YangPiCui/ErgonomicComputerKeyboard/Versions/ECK_0.2.0/README.md

# [Case](Case) 
. use low latency and cheap components (Teensy 2.0, atmega, rp2040)  
. desktop app to manage key maps - qwerty default and includes mine  

# Part List  

# Keymap 
[Layer0](http://www.keyboard-layout-editor.com/#/gists/2fc38dca845ec5f253bac7c052df82da)  
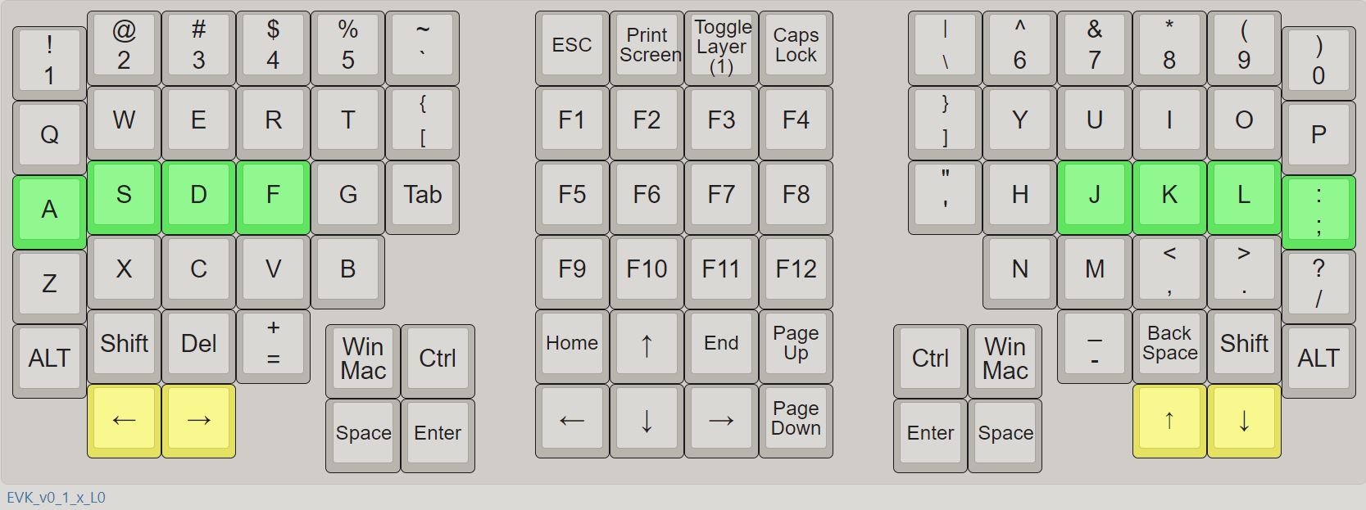
[picture p3: Versions/ECK_0.2.0/EVK_v0_1_x_L0.jpg]
  
[Layer1](http://www.keyboard-layout-editor.com/#/gists/1d35c2bdc8fc2de6860daa4e2ee97f45)  
I manually designed a keymap based on English [letter](https://norvig.com/mayzner.html) and [character](http://xahlee.info/comp/computer_language_char_distribution.html) frequencies. [It fares well against other traidtional layouts according to the Keyboard Layout Analyzer.](http://patorjk.com/keyboard-layout-analyzer/#/load/hqrGn4NG)  
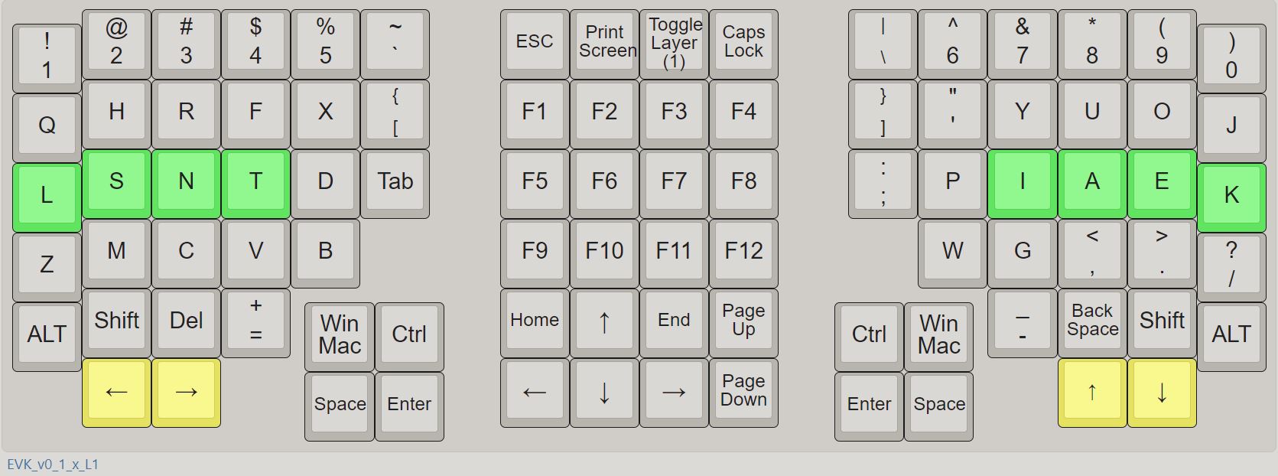
[picture p4: Versions/ECK_0.2.0/EVK_v0_1_x_L1.jpg]
  

# [Electronics, Firmware and Software](ElectronicsFirmwareSoftware)

# 3D Print 
"./3DPrintFiles/"  
"./CuraSlicerSettings/" 
The parts are of high precision. The fits are transitional clearance. [Calibrate](https://github.com/YangPiCui/3DPrinterCalibrationAndTuning/) your 3D printer accurately and follow the instructions closely. 

### Left Right and Front  
* Nozzle Diameter 0.3mm
* Layer Height 0.24mm
* Line Width 0.54mm
* Support Line Width 0.24mm for easy support removal   
* Tree Support Top Distance is 0.48mm, or twice the layer height. IMPORTANT. Do NOT set this value greater than what I have specified, otherwise the keyswitch might not fit. 
Print the Left Right and Front as if they would normally stand on the build plate. Set brim distance to 0mm for Front but not for Left or Right.  
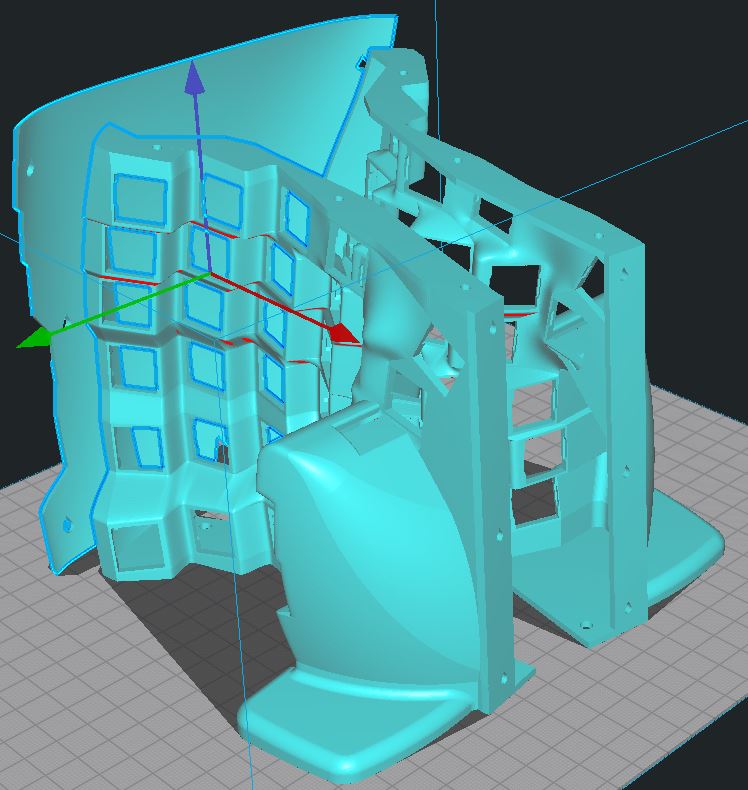
[picture p5: Versions/ECK_0.2.0/LeftRight0.jpg]
  
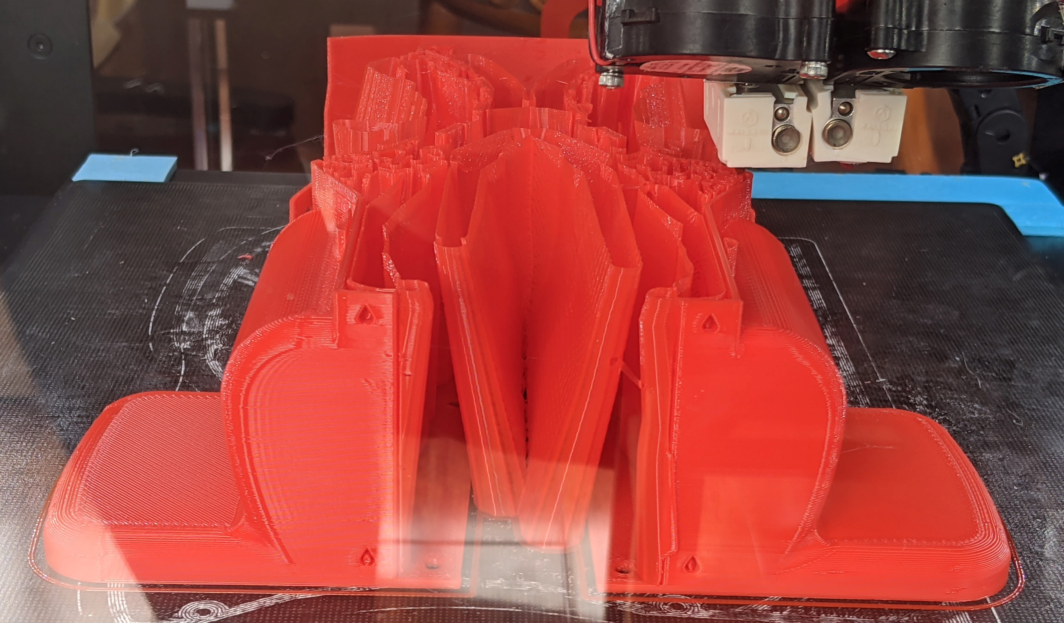
[picture p6: Versions/ECK_0.2.0/LeftRight1.jpg]
  
  
### Top Bottom and Back
If switches do not fit on the Top Plate. Try adjusting the Horizontal Expansion in Cura. 
  
### Keycaps
The keycaps are a press-fit onto the Cherry Switches!  
* Nozzle Diameter 0.3mm
* Layer Height = 0.16mm 
* Support still needed in this version. No support necessary starting at v0.1.1. 
* Brim & Support Brim = off; They are painful to remove.  
Print the keycaps as if they would sit on the build plate.  
KeycapHome x 12 (8 for the home row and 4 for the most bottom row)   
KeycapThumb x 4   
KeycapNormal x 74   
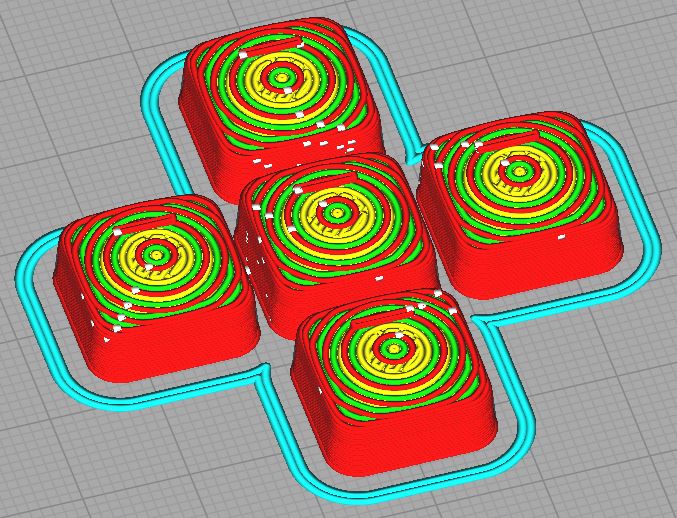
[picture p7: Versions/ECK_0.2.0/Keycap0.jpg]
    
Use a knife to trim the excess edges of the printed keycaps.

## Assembly

### Hot-glue Cherry Key Switches
Put some hot glue on the four corners of each keyswitch to secure it on the plates. Do it on the inside for a nicer outer finish.
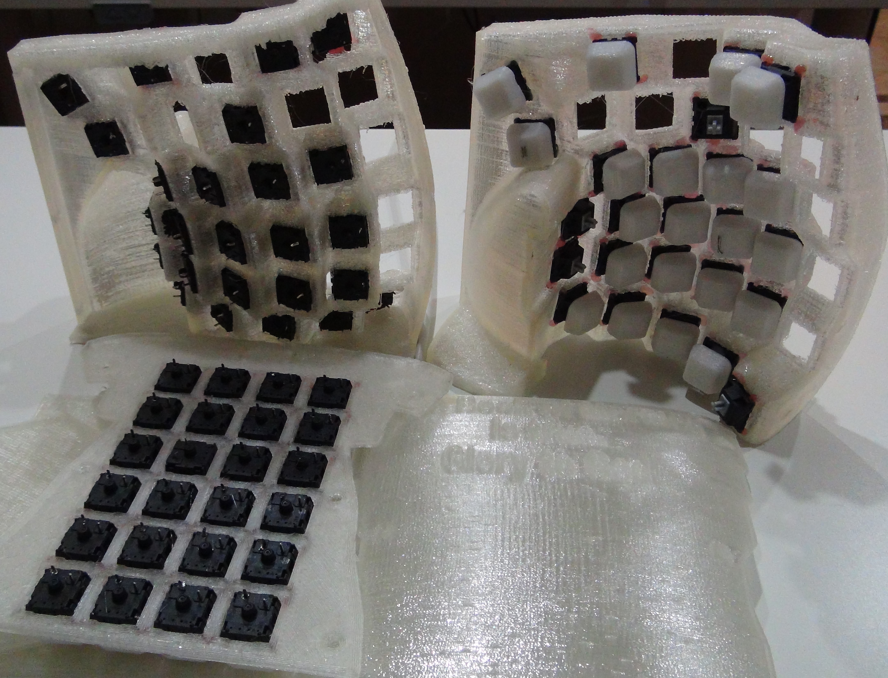
[picture p8: Versions/ECK_0.2.0/Hot-glueSwitches.JPG]
  

### Wire up the Keyboard Matrix  
Rows and columns on the physical keyboard:  
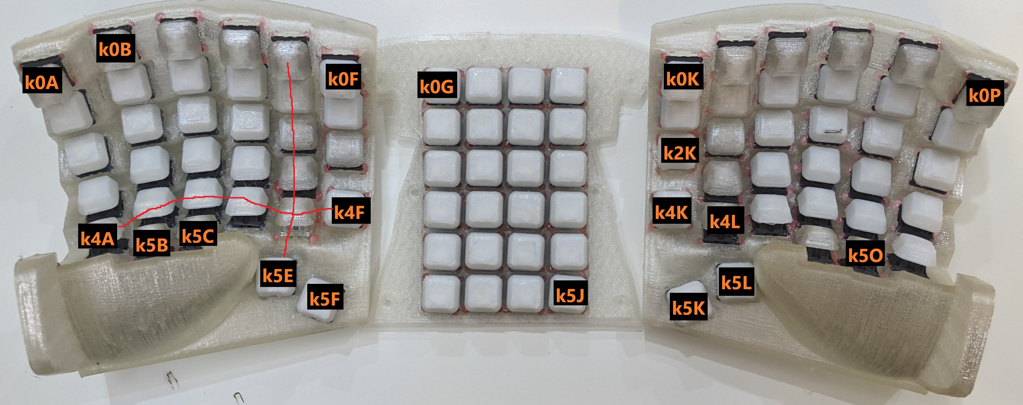
[picture p9: Versions/ECK_0.2.0/Keymapping.jpg]
  
Note #define DIODE_DIRECTION ROW2COL in config.h -- current flows from the positive Teensy pins into the matrix rows and out of the columns to the ground pin.  

### 0. Rows  
I used a naked wire to connect the switches on each row together. 
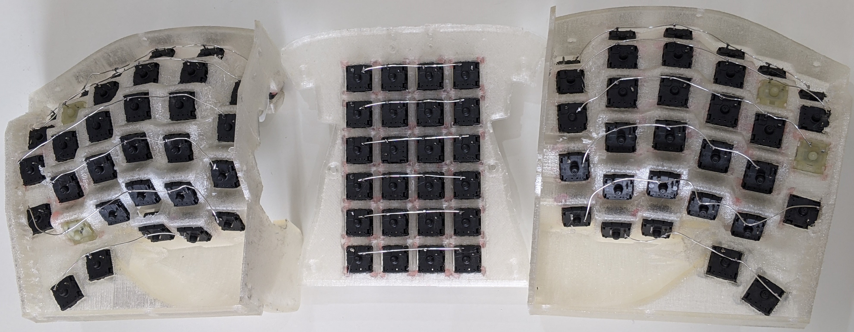
[picture p10: Versions/ECK_0.2.0/WireUpRows.jpg]
 

### 1. Columns
First solder the diodes. The diodes need the black bar facing away from the key. The diode's black bar indicates its negative terminal.  
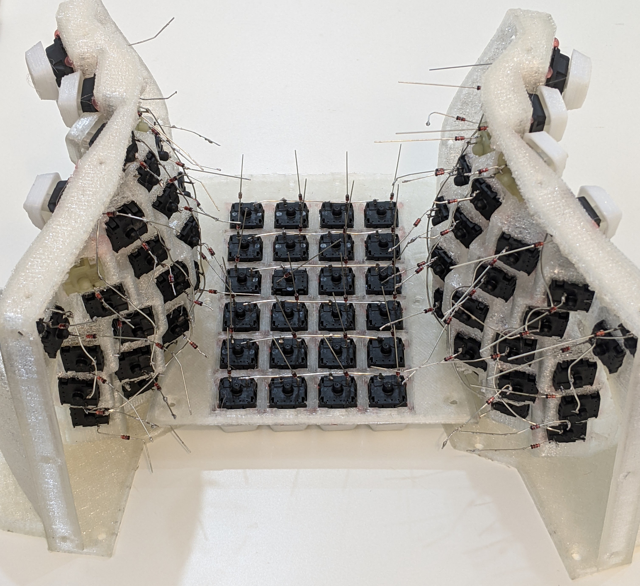
[picture p11: Versions/ECK_0.2.0/SolderDiodes.jpg]
  
  
Wire up the columns.  
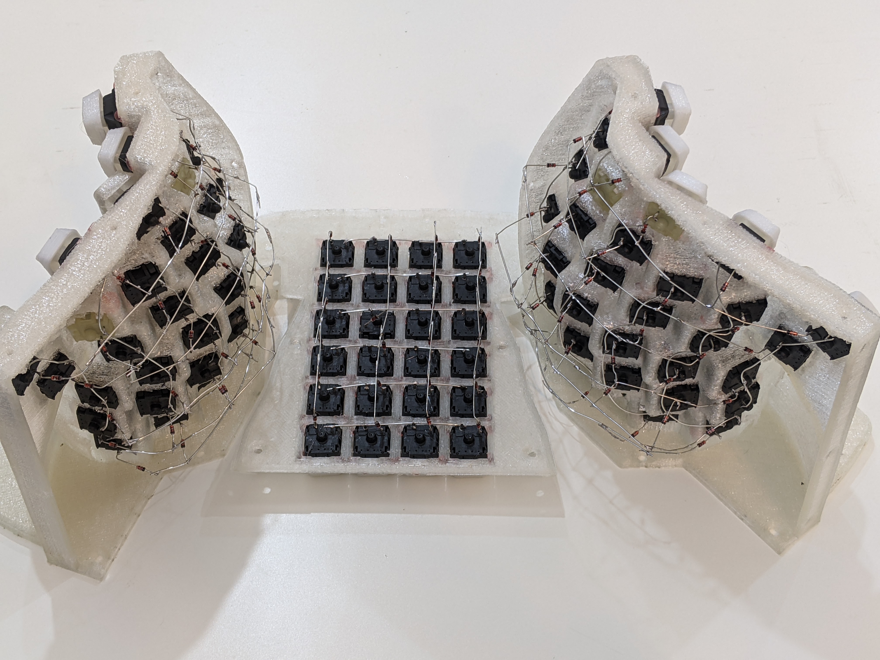
[picture p12: Versions/ECK_0.2.0/WireUpColumns.jpg]
  
  
Connect the rows.  
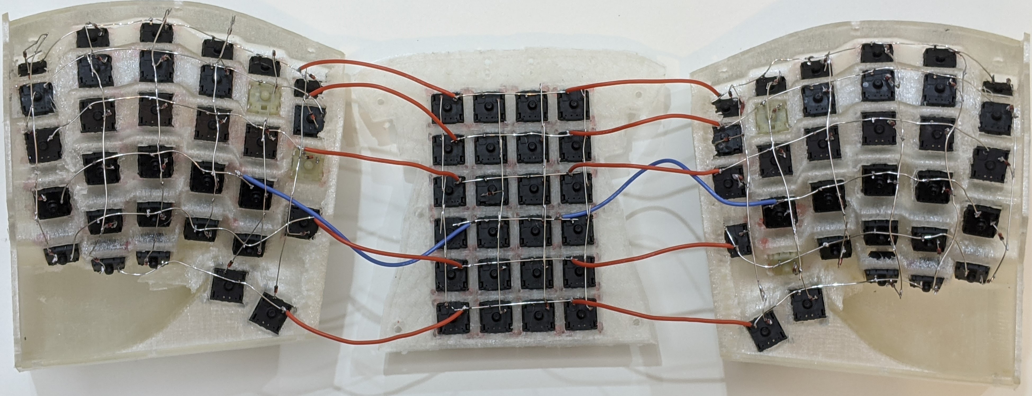
[picture p13: Versions/ECK_0.2.0/ConnectRows.jpg]
  

### Wire up the Micro Controller
Refer to the [3. Electronics, Firmware and Software](ElectronicsFirmwareAndSoftware) section for Teensy pinouts.
Capslock LED on pin D4 and layer switch indictation on pin D5.    
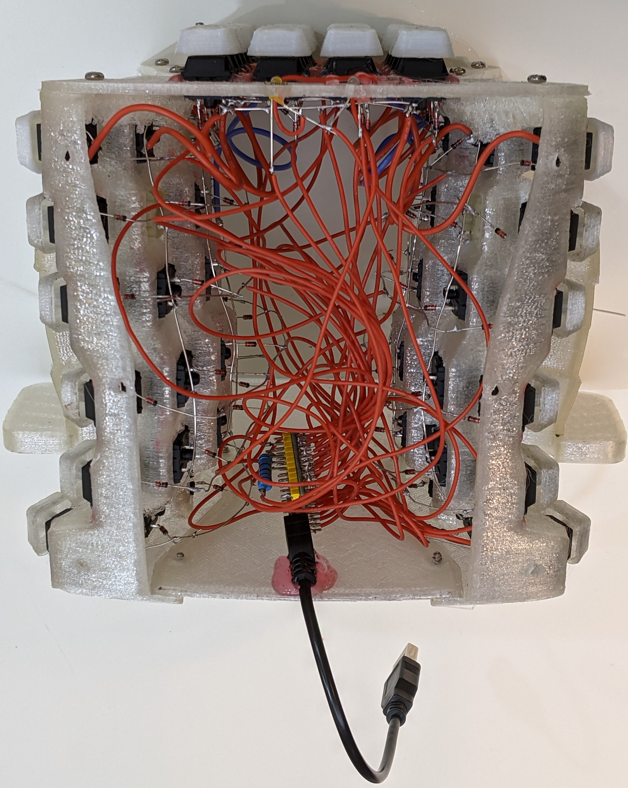
[picture p14: Versions/ECK_0.2.0/WireTeensy.jpg]
  
  
LEDsAndResetButton  
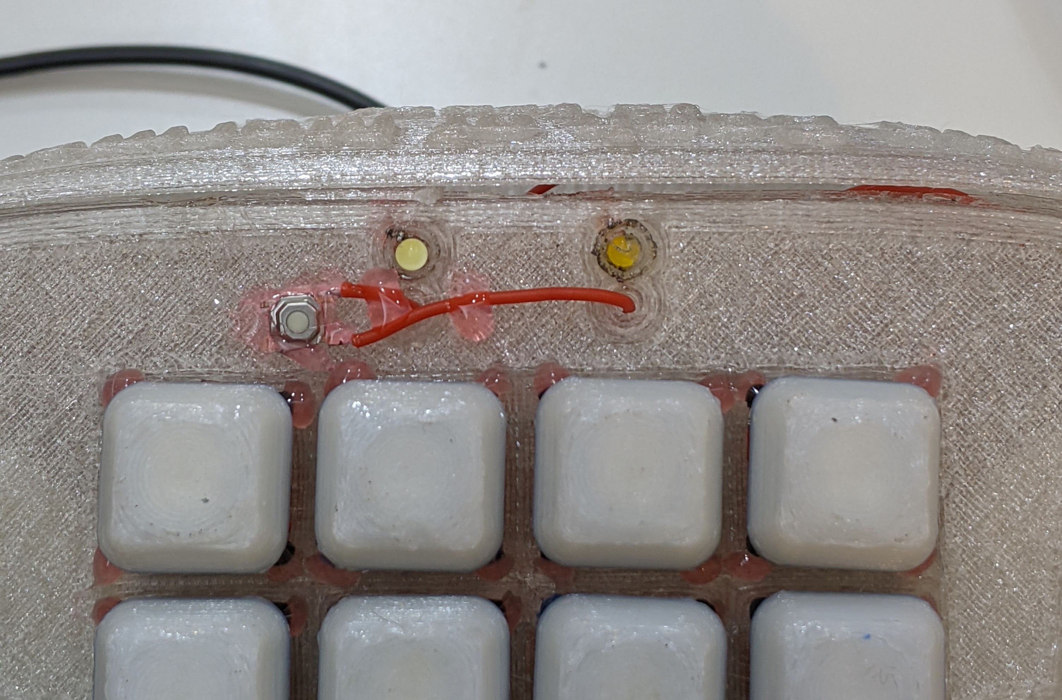
[picture p15: Versions/ECK_0.2.0/LEDsAndResetButton.jpg]
  

### Put on the Sillicon Rubber Feet  
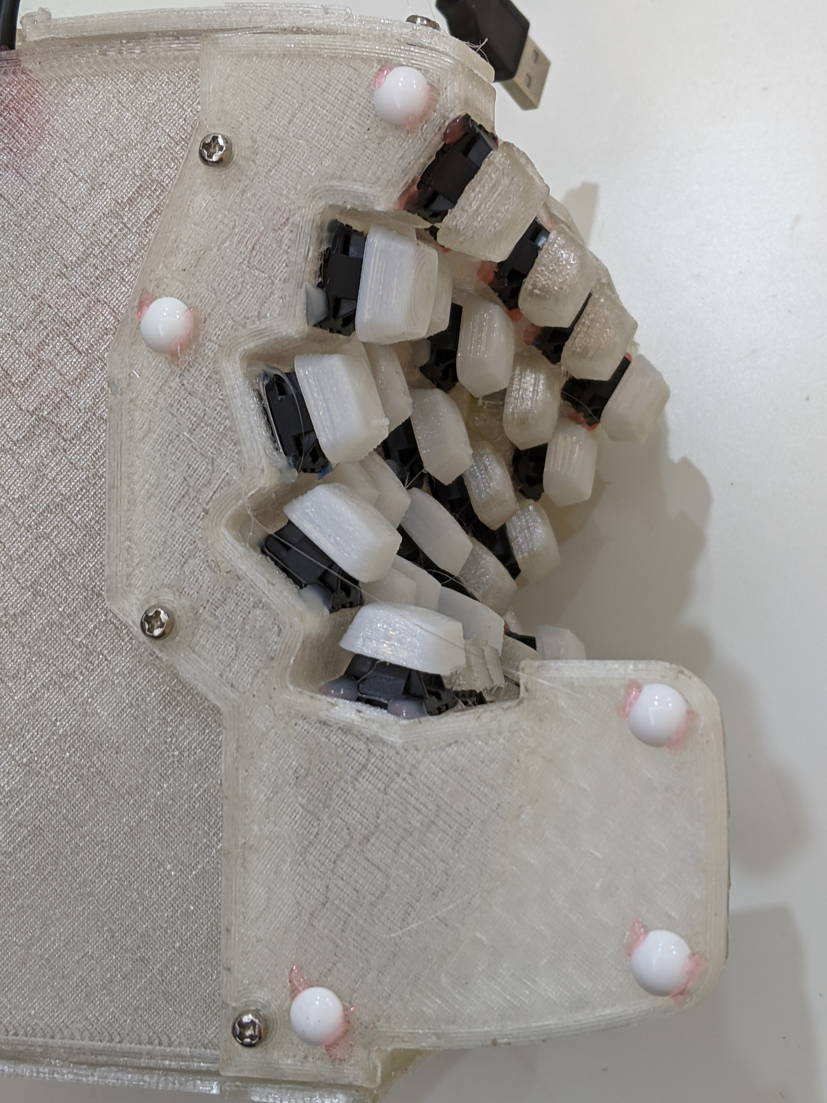
[picture p16: Versions/ECK_0.2.0/PutOnSilliconRubberFeet.jpg]
  

### Smile



###### [ODC Open Database License v1.0](https://choosealicense.com/appendix/)  (free but no patent or commercial use)
