YangPiCui/ErgonomicComputerKeyboard/Versions/EVK_v0.1.2/README.md

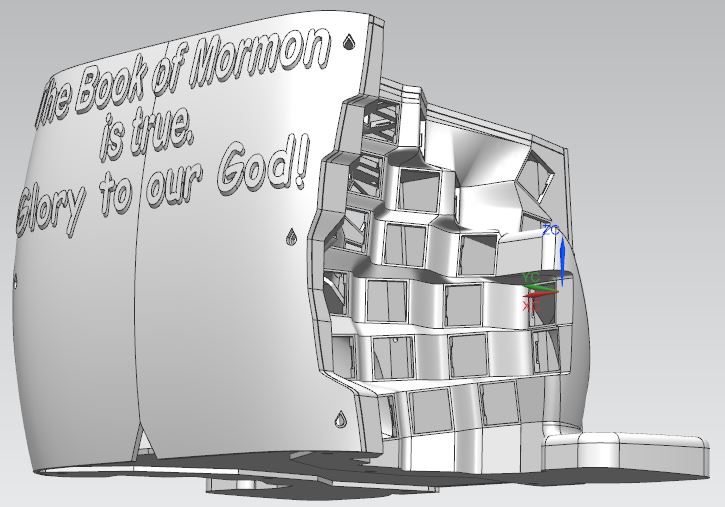
[picture p17: Versions/ECK_0.2.0/Case0.jpg]
  
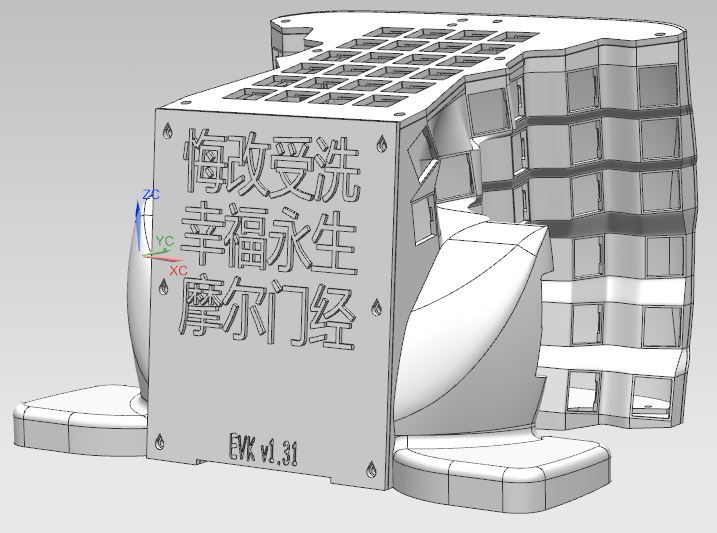
[picture p18: Versions/ECK_0.2.0/Case1.jpg]
  
 
 
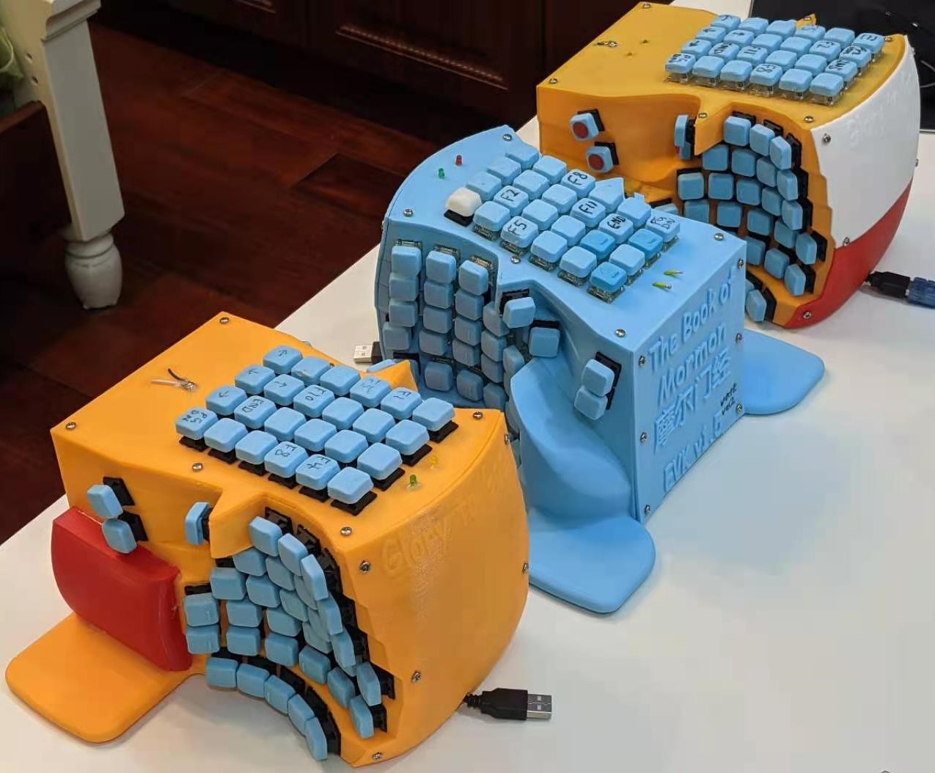
[picture p19: Versions/EVK_v0.1.2/Keyboard2.jpg]
 
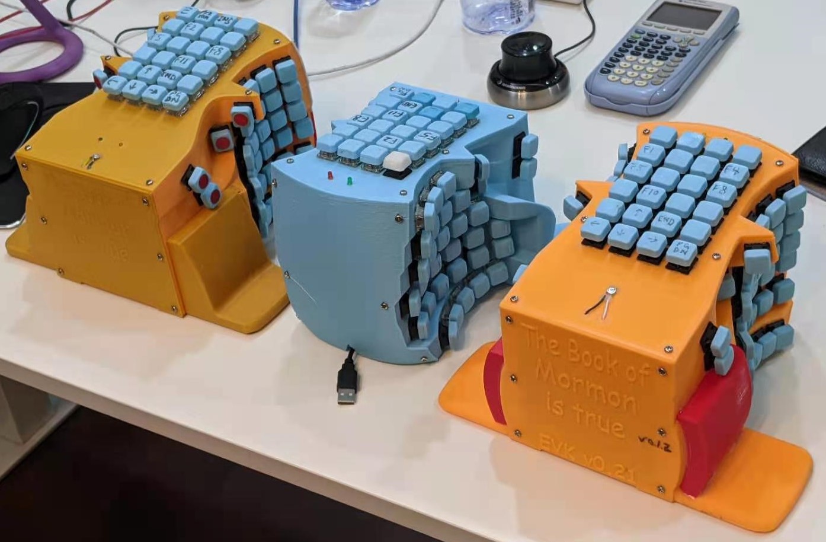
[picture p20: Versions/EVK_v0.1.2/Keyboard3.jpg]
    
  
Please refer to EVK_v0.1.1 for build instructions.   
  
Print sideStandingMount.3mf and flatLayingMount.3mf to check switch fit and tolerance.  


###### [ODC Open Database License v1.0](https://choosealicense.com/appendix/)  (free but no patent or commercial use)
