YangPiCui/ErgonomicComputerKeyboard/Versions/ECK_0.2.0/Case/DesignVersions/1/Design_1.docx

I am referencing the Kinesis Advantage 2. Kinesis Advantage 360 allows for roll angle but it has too few keys and who wants the extra hassle of a split keyboard?

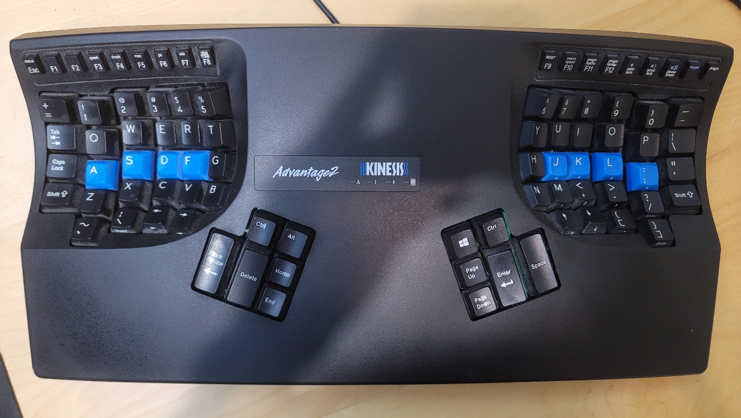
[picture p21: figure]

ECK should resemble the Kinesis Advantage 2 but tilted more and with more keys.

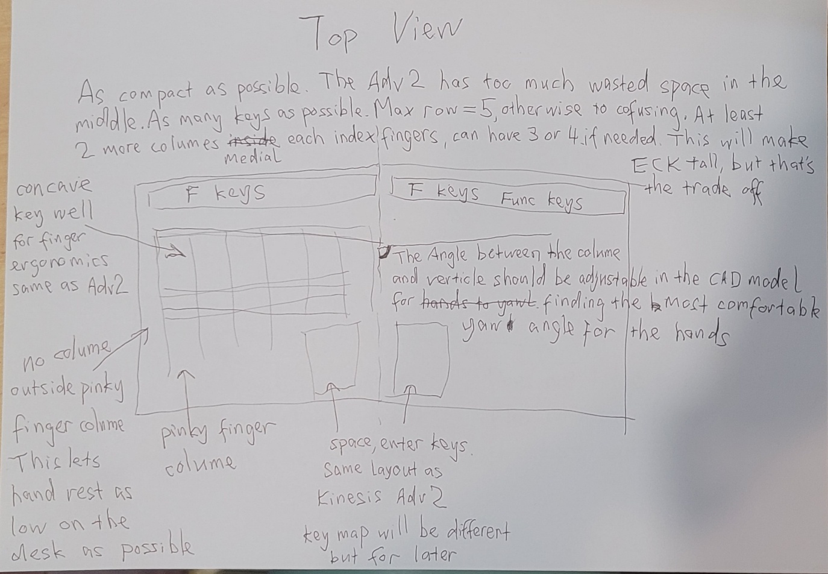
[picture p22: figure]

In addition to what’s written on the sheet of paper

. parametric so that other people can contribute adjust tolerances to fit their 3D printer (especially the switch holes)

. in parts to minimize 3D printing support structure

. standard keycaps

. hot swappable keys

. hard xor soft PCB depending on design

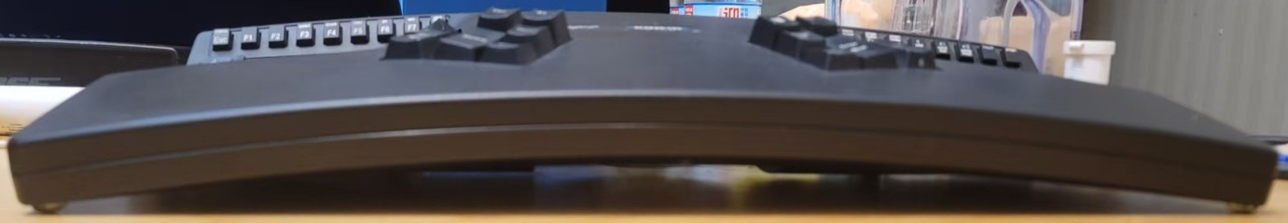
[picture p23: figure]
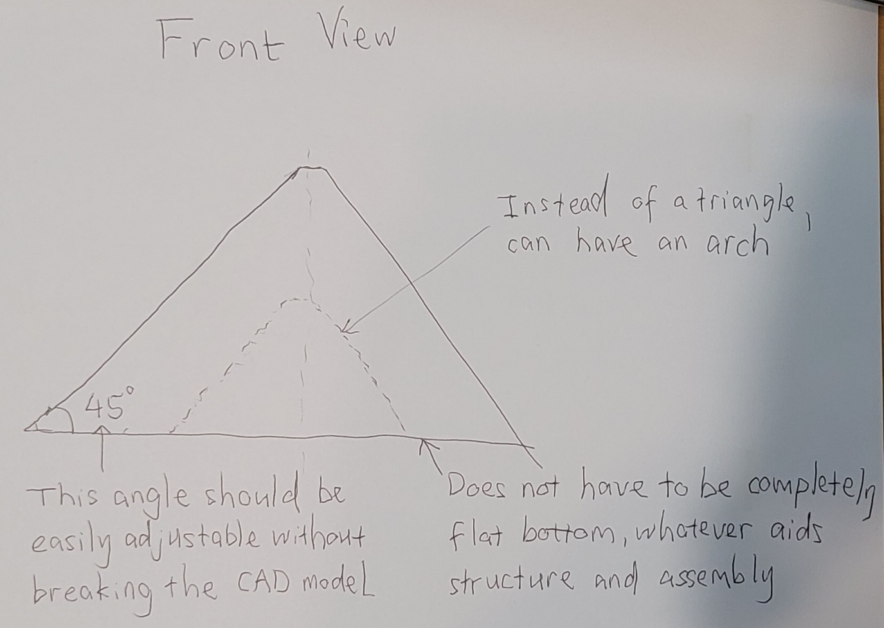
[picture p24: figure]
