YangPiCui/ErgonomicComputerKeyboard/Versions/EVK_v0.0/Case/EVK_v0.0_Siemens_NX_Files/HandAnthropometricData.xlsx

1.7mm Height Male | 1stKnuckleWidth | width | knuckleWidth | xDistanceToMid | yDistanceToMid | zDistanceToMid | length | lengthNeg | scale | height | circumference | maxAngleToHorizontal | angleToYZPlane
leftPalm |  | =76mm |  |  |  |  | =97mm | #VALUE!
leftThumb |  | =21mm |  | =55mm | =-6mm | #VALUE! |  |  |  | =19mm |  | 30 | 23
leftIndexFinger | =16mm | =19mm | =21mm | =3mm | =-1.5mm | #VALUE! | =91mm |  | #VALUE! |  | =59mm | =7.5deg
leftMiddleFinger |  | =18.5mm | =19mm | =0mm | =0mm | 0 | =100mm |  | 1 |  | =57mm | =0deg
leftRingFinger |  | =17mm | =17mm | =3mm | =-1.5mm | #VALUE! | =96mm |  | #VALUE! |  | =55mm | =-4.5deg
leftLittleFinger |  | =16.5mm | =19mm | =6mm | =-3mm | #VALUE! | =76mm |  | #VALUE! |  | =49mm | =-8.5deg
leftLowerArmPlusPalm |  |  |  |  |  |  | =310mm
 |  | angleToHomeCol | deltaX | deltaY | deltaZ | angleToXYPlane | xToOrigin | yToOrigin | zToOrigin
 | indexFinger2ndCol | #VALUE! | =0mm | #VALUE! | #VALUE! | #VALUE! | #VALUE! | #VALUE! | #VALUE!
 | indexFinger3rdCol | #VALUE! | =0mm | #VALUE! | #VALUE! | #VALUE! | #VALUE! | #VALUE! | #VALUE!
 |  | X | Y | Z | maxX (width) | maxY (length) | maxZ (height)
Cherry Switch
keyCap |  | =12.5mm | =12.5mm |  |  | =16mm
keyCapL |  | =12.5mm | =12.5mm
DB_PART_NO | OS_PART_NAME | fingerLength | firstKnuckleWidth | dX | dY | dZ | angleToMidFinger
part1 | indexFingerPath | 91 | 16 | 4.4 | -1.3 | 24.2 | 7.5
part2 | midFingerPath | 100 | 15.5 | 0 | 0 | 0 | 0 |  | In red & bold is the driving dimension.
part3 | ringFingerPath | 96 | 14.6 | 4.4 | -1.38 | -17.5 | 4.5
part4 | littleFingerPath | 76 | 13.3 | 5.5 | -2.7 | -33 | 8.5
