YangPiCui/ErgonomicComputerKeyboard/Versions/ECK_0.2.0/Case/DesignVersions/1/design_1_ECK_front_sketch.jpg

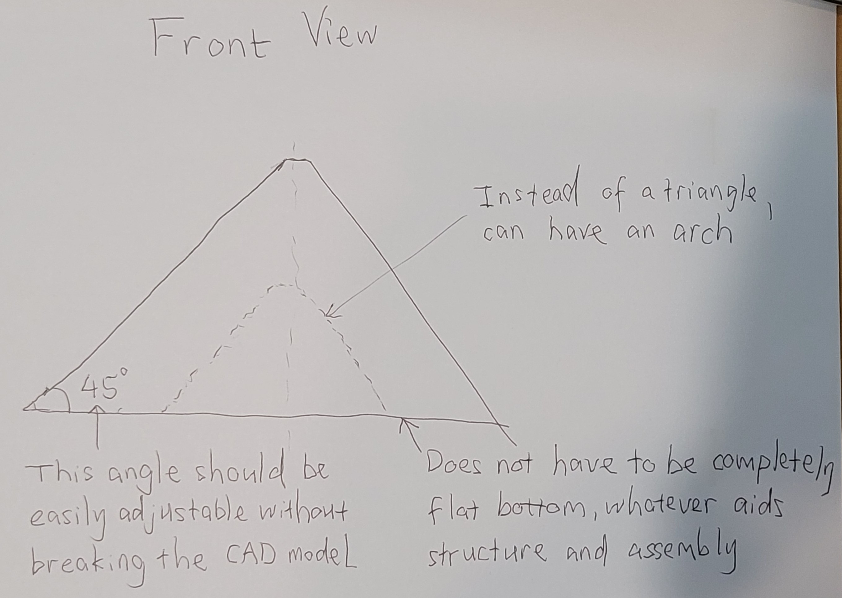
Versions/ECK_0.2.0/Case/DesignVersions/1/design_1_ECK_front_sketch.jpg
