YangPiCui/ErgonomicComputerKeyboard/Versions/ECK_0.2.0/Case/DesignVersions/1/Kinesis_Advantage2_CircuitBoard.jpg

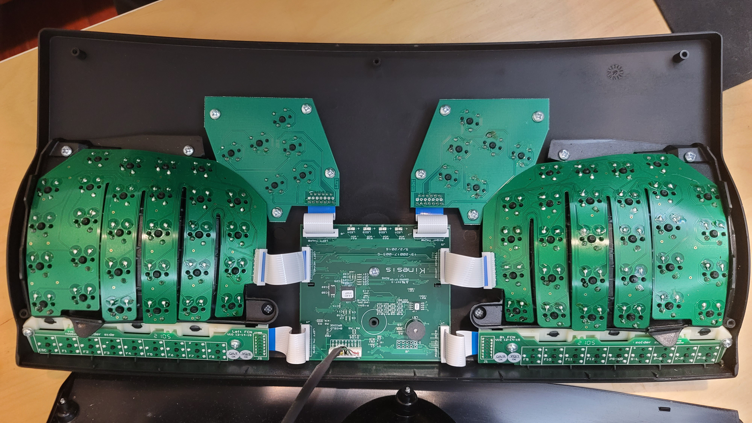
Versions/ECK_0.2.0/Case/DesignVersions/1/Kinesis_Advantage2_CircuitBoard.jpg
