YangPiCui/ErgonomicComputerKeyboard/Versions/EVK_v0.1.2/EVK_v0.1.2_Siemens_NX_Files/MidFingerPath.jpg

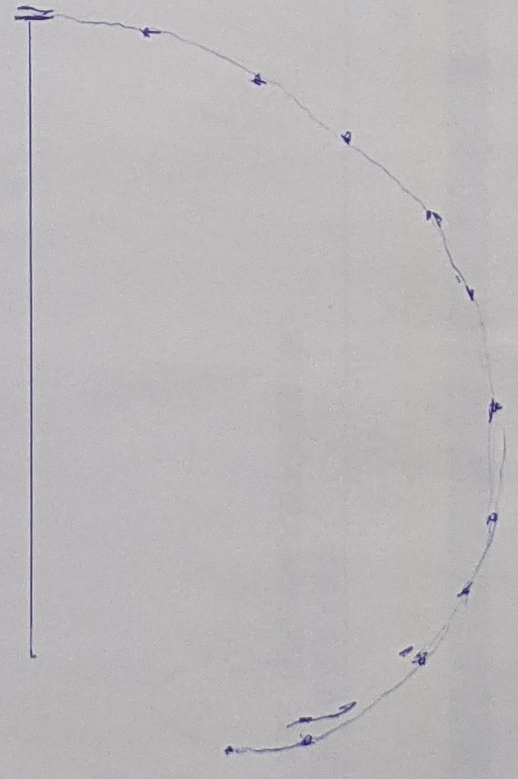
Versions/EVK_v0.1.2/EVK_v0.1.2_Siemens_NX_Files/MidFingerPath.jpg
