YangPiCui/ErgonomicComputerKeyboard/(list of files, cad)

Other CAD files:
Versions/EVK_v0.0/Case/EVK_v0.0_Siemens_NX_Files/ASM_Electronics.prt
Versions/EVK_v0.0/Case/EVK_v0.0_Siemens_NX_Files/ASM_Key.prt
Versions/EVK_v0.0/Case/EVK_v0.0_Siemens_NX_Files/ASM_MASTER_MidFingeColumn.prt
Versions/EVK_v0.0/Case/EVK_v0.0_Siemens_NX_Files/ASM_Main.prt
Versions/EVK_v0.0/Case/EVK_v0.0_Siemens_NX_Files/ASM_SLAVE_IndexFingerColumn.prt
Versions/EVK_v0.0/Case/EVK_v0.0_Siemens_NX_Files/ASM_SLAVE_LittleFingerColumn.prt
Versions/EVK_v0.0/Case/EVK_v0.0_Siemens_NX_Files/ASM_SLAVE_MidFingerColumn.prt
Versions/EVK_v0.0/Case/EVK_v0.0_Siemens_NX_Files/ASM_SLAVE_RingFingerColumn.prt
Versions/EVK_v0.0/Case/EVK_v0.0_Siemens_NX_Files/ASM_SLAVE_RingFingerPath.prt
Versions/EVK_v0.0/Case/EVK_v0.0_Siemens_NX_Files/ASM_ThumbPlate.prt
Versions/EVK_v0.0/Case/EVK_v0.0_Siemens_NX_Files/BaseKnucklesPath.prt
Versions/EVK_v0.0/Case/EVK_v0.0_Siemens_NX_Files/CherryKey.prt
Versions/EVK_v0.0/Case/EVK_v0.0_Siemens_NX_Files/ConnectorRods.prt
Versions/EVK_v0.0/Case/EVK_v0.0_Siemens_NX_Files/HandRestLeft.prt
Versions/EVK_v0.0/Case/EVK_v0.0_Siemens_NX_Files/HexSocketCylindricalHead_M6x80.prt
Versions/EVK_v0.0/Case/EVK_v0.0_Siemens_NX_Files/IndexFingerPathsConstraint.prt
Versions/EVK_v0.0/Case/EVK_v0.0_Siemens_NX_Files/KeyCapConcave.prt
Versions/EVK_v0.0/Case/EVK_v0.0_Siemens_NX_Files/KeyCapConvex.prt
Versions/EVK_v0.0/Case/EVK_v0.0_Siemens_NX_Files/KeyCapHome.prt
Versions/EVK_v0.0/Case/EVK_v0.0_Siemens_NX_Files/KeyCapStem.prt
Versions/EVK_v0.0/Case/EVK_v0.0_Siemens_NX_Files/KeyCapThumb.prt
Versions/EVK_v0.0/Case/EVK_v0.0_Siemens_NX_Files/SwitchMount.prt
Versions/EVK_v0.0/Case/EVK_v0.0_Siemens_NX_Files/Teensy2.0.prt
Versions/EVK_v0.0/Case/EVK_v0.0_Siemens_NX_Files/ThumbPath.prt
Versions/EVK_v0.0/Case/EVK_v0.0_Siemens_NX_Files/ThumbPath_OLD.prt
Versions/EVK_v0.0/Case/EVK_v0.0_Siemens_NX_Files/ToleranceAndClearance.prt
Versions/EVK_v0.1.0/CaseDesign/EVK_v0.1.0_Siemens_NX_Files/ASM_Key.prt
Versions/EVK_v0.1.0/CaseDesign/EVK_v0.1.0_Siemens_NX_Files/ASM_MASTER_MidFingeColumn.prt
Versions/EVK_v0.1.0/CaseDesign/EVK_v0.1.0_Siemens_NX_Files/ASM_SLAVE_IndexFingerColumn.prt
Versions/EVK_v0.1.0/CaseDesign/EVK_v0.1.0_Siemens_NX_Files/ASM_SLAVE_LittleFingerColumn.prt
Versions/EVK_v0.1.0/CaseDesign/EVK_v0.1.0_Siemens_NX_Files/ASM_SLAVE_MidFingerColumn.prt
Versions/EVK_v0.1.0/CaseDesign/EVK_v0.1.0_Siemens_NX_Files/ASM_SLAVE_RingFingerColumn.prt
Versions/EVK_v0.1.0/CaseDesign/EVK_v0.1.0_Siemens_NX_Files/ASM_ThumbKeys.prt
Versions/EVK_v0.1.0/CaseDesign/EVK_v0.1.0_Siemens_NX_Files/ASM_TopPlate.prt
Versions/EVK_v0.1.0/CaseDesign/EVK_v0.1.0_Siemens_NX_Files/BaseKnucklesPath.prt
Versions/EVK_v0.1.0/CaseDesign/EVK_v0.1.0_Siemens_NX_Files/CherryKey.prt
Versions/EVK_v0.1.0/CaseDesign/EVK_v0.1.0_Siemens_NX_Files/ConnectorRods.prt
Versions/EVK_v0.1.0/CaseDesign/EVK_v0.1.0_Siemens_NX_Files/ExtraIndexFingerPathsConstraint.prt
Versions/EVK_v0.1.0/CaseDesign/EVK_v0.1.0_Siemens_NX_Files/HexSocketCylindricalHead_M6x80.prt
Versions/EVK_v0.1.0/CaseDesign/EVK_v0.1.0_Siemens_NX_Files/KeyCapBaseModel.prt
Versions/EVK_v0.1.0/CaseDesign/EVK_v0.1.0_Siemens_NX_Files/KeyCapConvex.prt
Versions/EVK_v0.1.0/CaseDesign/EVK_v0.1.0_Siemens_NX_Files/KeyCapHome.prt
Versions/EVK_v0.1.0/CaseDesign/EVK_v0.1.0_Siemens_NX_Files/KeyCapNormal.prt
Versions/EVK_v0.1.0/CaseDesign/EVK_v0.1.0_Siemens_NX_Files/KeyCapThumb.prt
Versions/EVK_v0.1.0/CaseDesign/EVK_v0.1.0_Siemens_NX_Files/SwitchMount.prt
Versions/EVK_v0.1.0/CaseDesign/EVK_v0.1.0_Siemens_NX_Files/Teensy2.0.prt
Versions/EVK_v0.1.0/CaseDesign/EVK_v0.1.0_Siemens_NX_Files/ThumbPath.prt
Versions/EVK_v0.1.0/CaseDesign/EVK_v0.1.0_Siemens_NX_Files/ThumbPath_OLD.prt
Versions/EVK_v0.1.0/CaseDesign/EVK_v0.1.0_Siemens_NX_Files/ToleranceAndClearance.prt
Versions/EVK_v0.1.1/EVK_v0.1.1_Siemens_NX_Files/ASM_Key.prt
Versions/EVK_v0.1.1/EVK_v0.1.1_Siemens_NX_Files/ASM_MASTER_MidFingeColumn.prt
Versions/EVK_v0.1.1/EVK_v0.1.1_Siemens_NX_Files/ASM_SLAVE_IndexFingerColumn.prt
Versions/EVK_v0.1.1/EVK_v0.1.1_Siemens_NX_Files/ASM_SLAVE_LittleFingerColumn.prt
Versions/EVK_v0.1.1/EVK_v0.1.1_Siemens_NX_Files/ASM_SLAVE_MidFingerColumn.prt
Versions/EVK_v0.1.1/EVK_v0.1.1_Siemens_NX_Files/ASM_SLAVE_RingFingerColumn.prt
Versions/EVK_v0.1.1/EVK_v0.1.1_Siemens_NX_Files/ASM_ThumbKeys.prt
Versions/EVK_v0.1.1/EVK_v0.1.1_Siemens_NX_Files/ASM_TopPlate.prt
Versions/EVK_v0.1.1/EVK_v0.1.1_Siemens_NX_Files/BaseKnucklesPath.prt
Versions/EVK_v0.1.1/EVK_v0.1.1_Siemens_NX_Files/CherryKey.prt
Versions/EVK_v0.1.1/EVK_v0.1.1_Siemens_NX_Files/ConnectorRods.prt
Versions/EVK_v0.1.1/EVK_v0.1.1_Siemens_NX_Files/ExtraIndexFingerPathsConstraint.prt
Versions/EVK_v0.1.1/EVK_v0.1.1_Siemens_NX_Files/HexSocketCylindricalHead_M6x80.prt
Versions/EVK_v0.1.1/EVK_v0.1.1_Siemens_NX_Files/KeyCapBaseModel.prt
Versions/EVK_v0.1.1/EVK_v0.1.1_Siemens_NX_Files/KeyCapHome.prt
Versions/EVK_v0.1.1/EVK_v0.1.1_Siemens_NX_Files/KeyCapNormal.prt
Versions/EVK_v0.1.1/EVK_v0.1.1_Siemens_NX_Files/SwitchMount.prt
Versions/EVK_v0.1.1/EVK_v0.1.1_Siemens_NX_Files/Teensy2.0.prt
Versions/EVK_v0.1.1/EVK_v0.1.1_Siemens_NX_Files/ThumbPath.prt
Versions/EVK_v0.1.1/EVK_v0.1.1_Siemens_NX_Files/ThumbPath_OLD.prt
Versions/EVK_v0.1.1/EVK_v0.1.1_Siemens_NX_Files/ToleranceAndClearance.prt
Versions/EVK_v0.1.2/EVK_v0.1.2_Siemens_NX_Files/ASM_Key.prt
Versions/EVK_v0.1.2/EVK_v0.1.2_Siemens_NX_Files/ASM_MASTER_MidFingeColumn.prt
Versions/EVK_v0.1.2/EVK_v0.1.2_Siemens_NX_Files/ASM_SLAVE_IndexFingerColumn.prt
Versions/EVK_v0.1.2/EVK_v0.1.2_Siemens_NX_Files/ASM_SLAVE_LittleFingerColumn.prt
Versions/EVK_v0.1.2/EVK_v0.1.2_Siemens_NX_Files/ASM_SLAVE_MidFingerColumn.prt
Versions/EVK_v0.1.2/EVK_v0.1.2_Siemens_NX_Files/ASM_SLAVE_RingFingerColumn.prt
Versions/EVK_v0.1.2/EVK_v0.1.2_Siemens_NX_Files/ASM_ThumbKeys.prt
Versions/EVK_v0.1.2/EVK_v0.1.2_Siemens_NX_Files/ASM_TopPlate.prt
Versions/EVK_v0.1.2/EVK_v0.1.2_Siemens_NX_Files/BaseKnucklesPath.prt
Versions/EVK_v0.1.2/EVK_v0.1.2_Siemens_NX_Files/CherryKey.prt
Versions/EVK_v0.1.2/EVK_v0.1.2_Siemens_NX_Files/ConnectorRods.prt
Versions/EVK_v0.1.2/EVK_v0.1.2_Siemens_NX_Files/ExtraIndexFingerPathsConstraint.prt
Versions/EVK_v0.1.2/EVK_v0.1.2_Siemens_NX_Files/HexSocketCylindricalHead_M6x80.prt
Versions/EVK_v0.1.2/EVK_v0.1.2_Siemens_NX_Files/KeyCapBaseModel.prt
Versions/EVK_v0.1.2/EVK_v0.1.2_Siemens_NX_Files/KeyCapHome.prt
Versions/EVK_v0.1.2/EVK_v0.1.2_Siemens_NX_Files/KeyCapNormal.prt
Versions/EVK_v0.1.2/EVK_v0.1.2_Siemens_NX_Files/SwitchMount.prt
Versions/EVK_v0.1.2/EVK_v0.1.2_Siemens_NX_Files/SwitchMount3DPrintTest.prt
Versions/EVK_v0.1.2/EVK_v0.1.2_Siemens_NX_Files/Teensy2.0.prt
Versions/EVK_v0.1.2/EVK_v0.1.2_Siemens_NX_Files/ThumbPath.prt
Versions/EVK_v0.1.2/EVK_v0.1.2_Siemens_NX_Files/ToleranceAndClearance.prt
